cweilguny/cheeseroller/publish/images/Assembly_Step_03.jpg

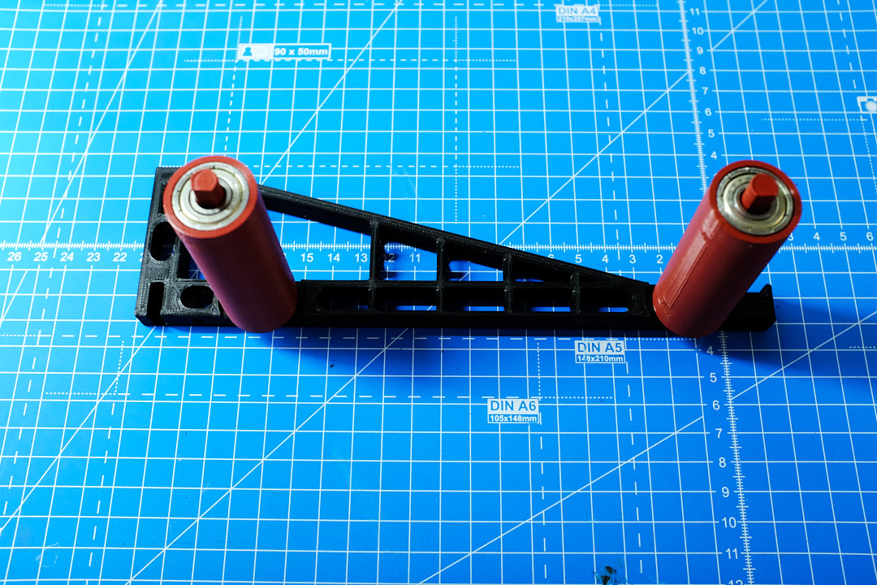
publish/images/Assembly_Step_03.jpg
