cweilguny/cheeseroller/publish/images/Overview_01.jpg

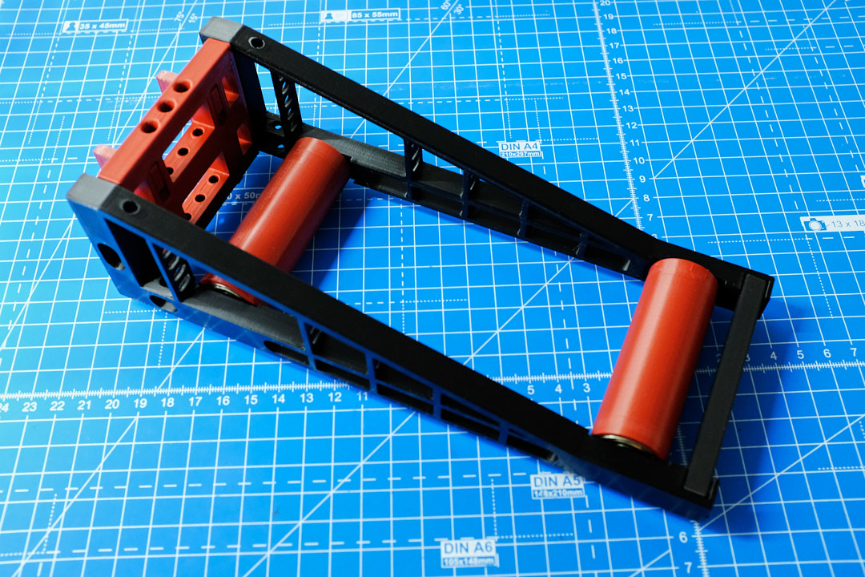
publish/images/Overview_01.jpg
