cweilguny/cheeseroller/README.md

# CheeseRoller

CheeseRoller is a 3D printable filament spool holder
for the Ikea Skadis pegboard that can be customized
to an arbitrary spool width.

See https://www.thingiverse.com/thing:4879591 for the
published version including all renderings.
