cweilguny/cheeseroller/publish/images/CheeseRollers.jpg

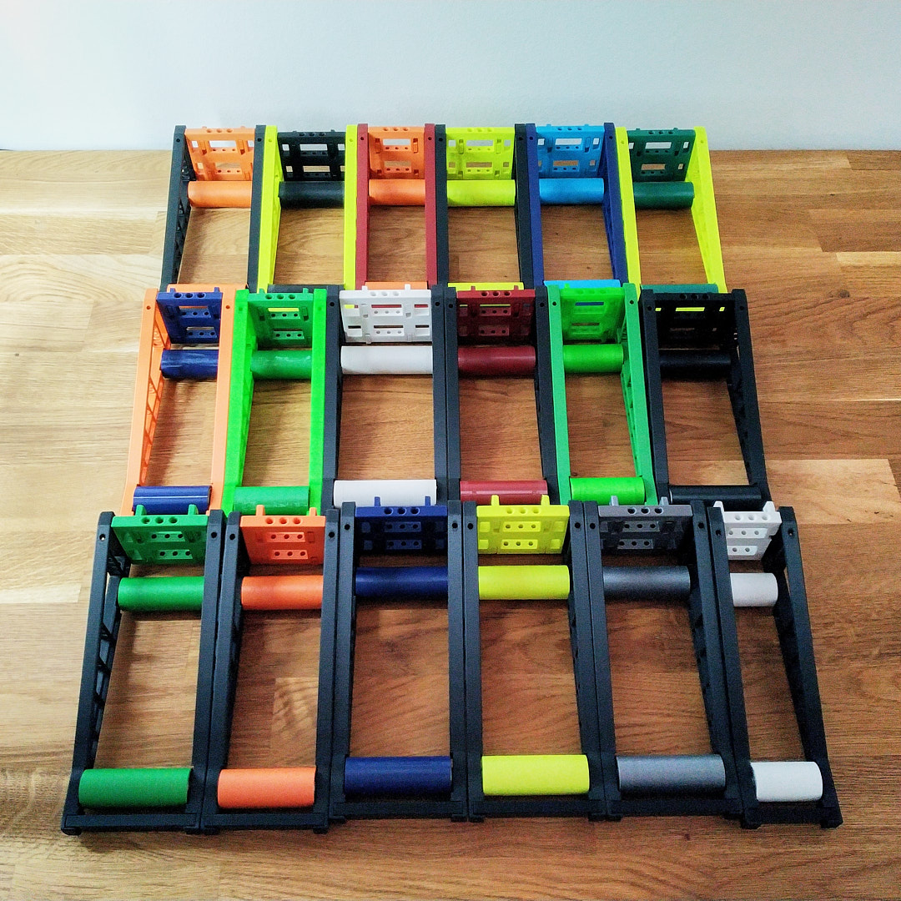
publish/images/CheeseRollers.jpg
