cweilguny/cheeseroller/publish/images/Overview_02.jpg

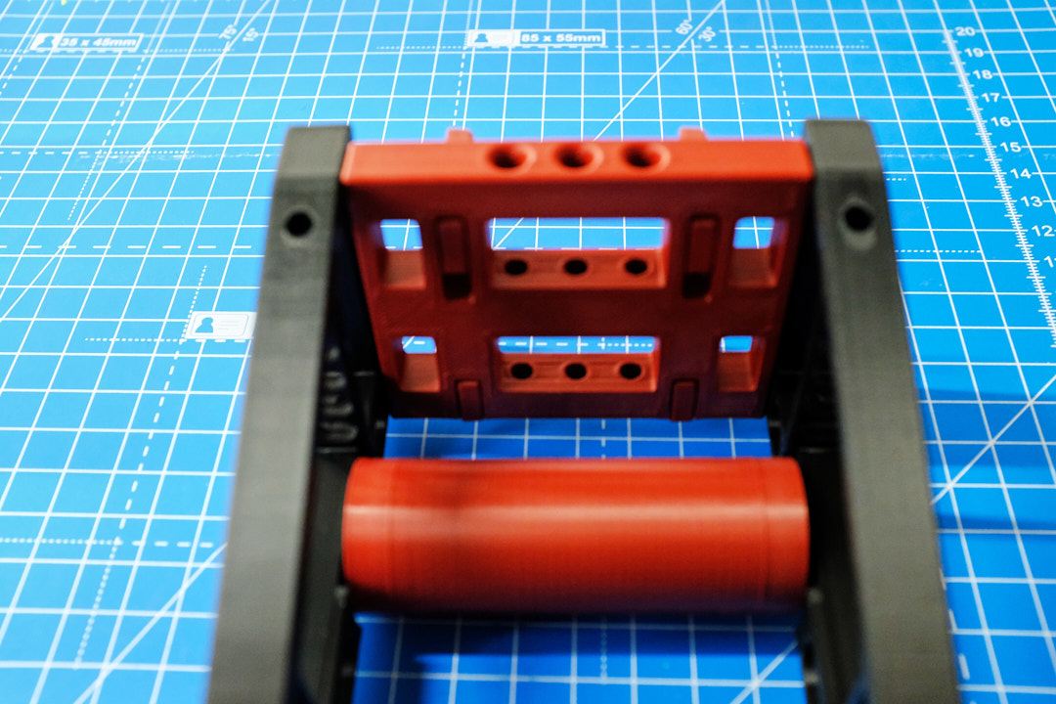
publish/images/Overview_02.jpg
