cweilguny/cheeseroller/publish/images/Overview_03.jpg

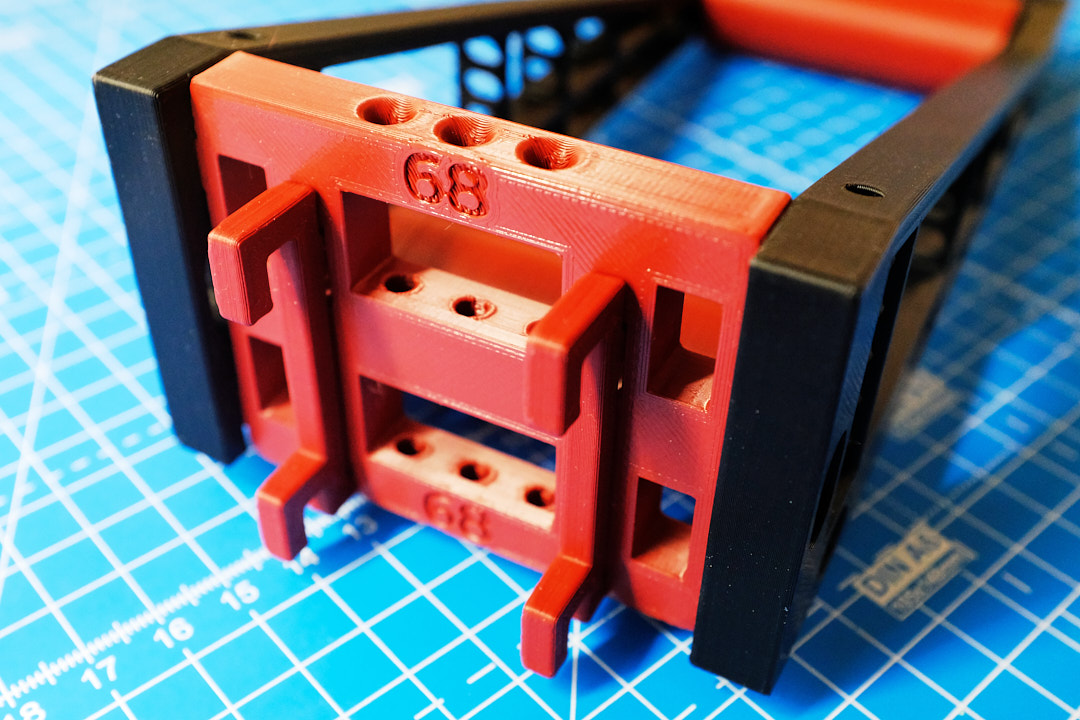
publish/images/Overview_03.jpg
