cweilguny/cheeseroller/publish/images/Spool_Wall_01.jpg

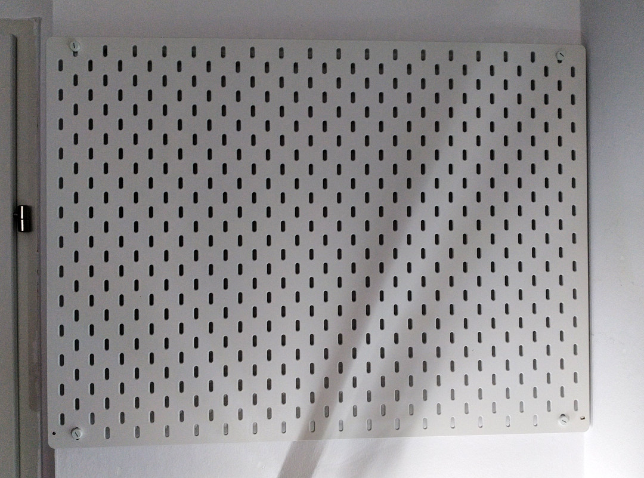
publish/images/Spool_Wall_01.jpg
