cweilguny/cheeseroller/publish/images/Spool_Wall_02.jpg

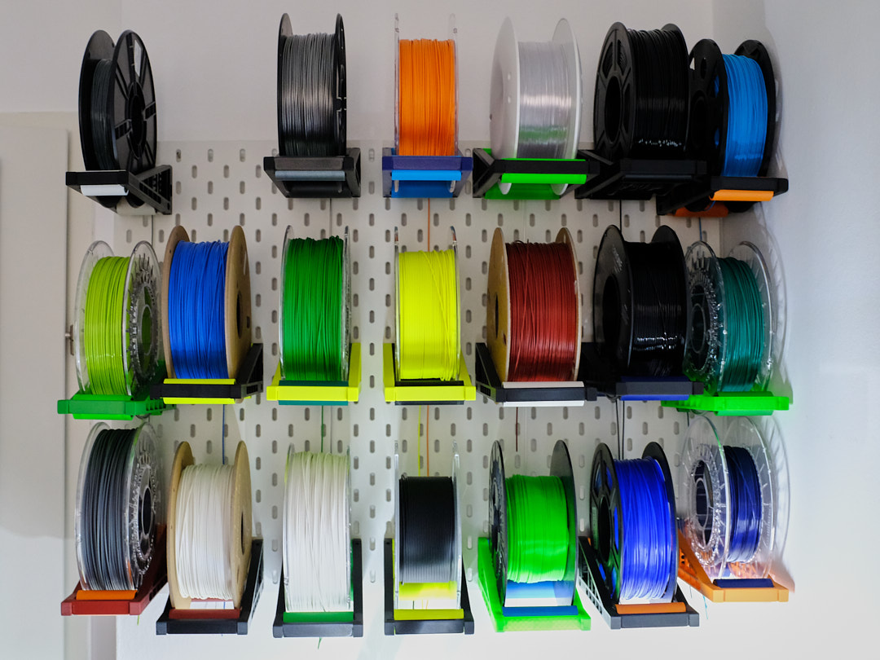
publish/images/Spool_Wall_02.jpg
