cweilguny/cheeseroller/publish/images/Spool_Wall_03.jpg

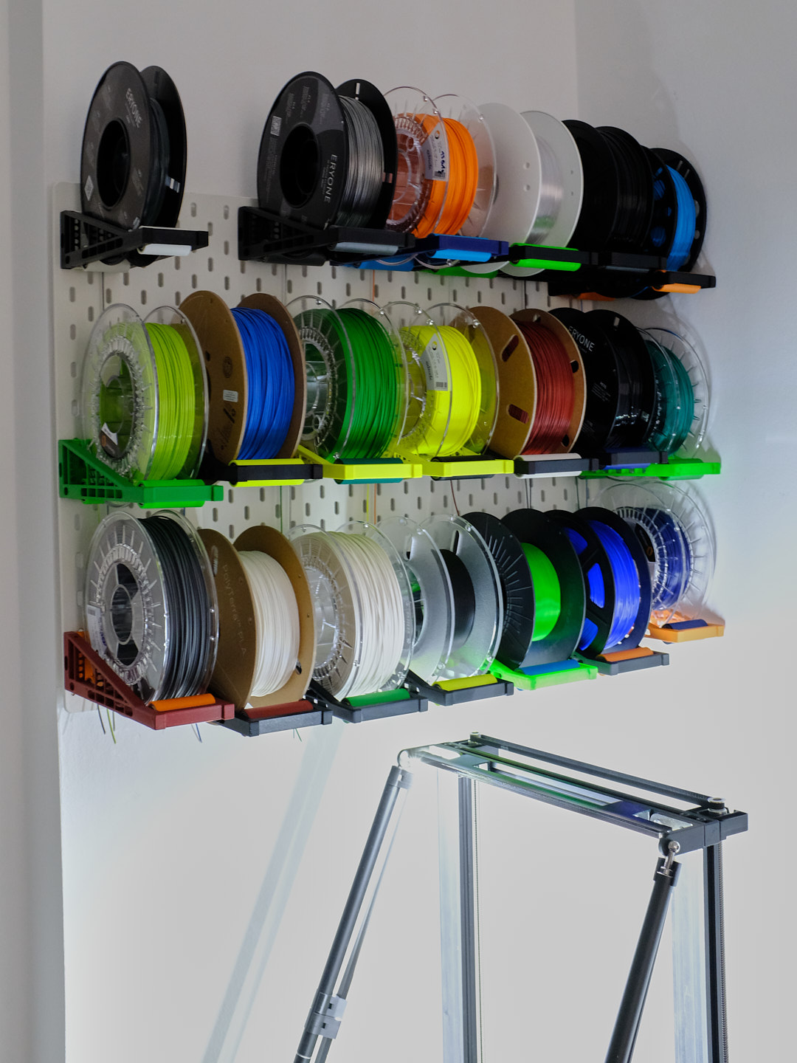
publish/images/Spool_Wall_03.jpg
