cweilguny/cheeseroller/publish/images/Spool_Wall_04.jpg

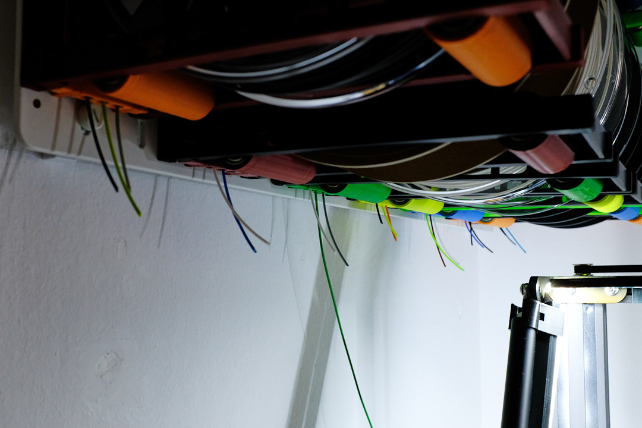
publish/images/Spool_Wall_04.jpg
