cweilguny/cheeseroller/publish/images/Spool_Wall_05.jpg

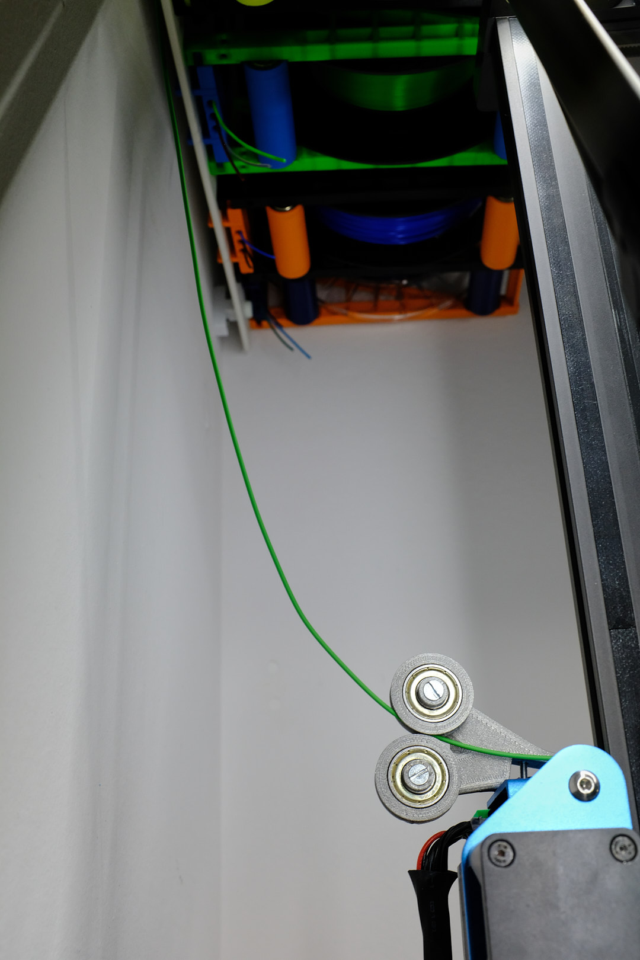
publish/images/Spool_Wall_05.jpg
