cweilguny/cheeseroller/scad/includes/CheeseRoller Variables Height Units.scad

HOOK_HEIGHT_TOTAL = HOOK_H * HEIGHT_UNITS + HOOK_DIFF_V * (HEIGHT_UNITS - 1);
