cweilguny/cheeseroller/publish/Assembly.md

Assembly and usage are easy. After the print assemble the parts like in the photographs:

**All parts including the 608ZZ bearings:**

----------------------------------------------------------------------------------------------------

**Put the bearings into the rolls on both sides. If they are a bit tight, press them in with a little more force, for example by pushing the roll on the bearing from the top.**

----------------------------------------------------------------------------------------------------

**The bearings seated in the rolls:**

----------------------------------------------------------------------------------------------------

**Put the pins through the bearing on one side, through the roll, and through the bearing on the other side:**

----------------------------------------------------------------------------------------------------

**The pins placed through the whole roll and both bearings:**

----------------------------------------------------------------------------------------------------

**Place the pins with the rolls on them into the slots in one arm:**

----------------------------------------------------------------------------------------------------

**Place the mount plate with the size label facing backwards into the slots of the arm:**

----------------------------------------------------------------------------------------------------

**Slide the mountplate towards the top of the arm until the top and the bottom of the mount plate are aligned with the top and bottom of the arm:**

----------------------------------------------------------------------------------------------------

**Place the second arm on the whole construction:**

----------------------------------------------------------------------------------------------------

**To fit the second arm, you need to skew the rolls and the arm a bit to fit the mount plate's hooks and both roll pins in the second arm:**

----------------------------------------------------------------------------------------------------

**Slide the mount plate towards the top of the second arm until the top and the bottom of the mount plate are aligned with the top and bottom of the arm:**

----------------------------------------------------------------------------------------------------

**Grab the connector:**

----------------------------------------------------------------------------------------------------

**Place it into the slots on the front of the arms, with the size label facing backwards:**

----------------------------------------------------------------------------------------------------

**Push the connector into the slots, until it's top is flush with the top of the arms:**

----------------------------------------------------------------------------------------------------

**Push the hooks through the slots on the mountplate:**

----------------------------------------------------------------------------------------------------

**Slide the hooks up so their bottom is flush with the mountplate's bottom:**

----------------------------------------------------------------------------------------------------

**You're done with the assembly, your new CheeseRoller should look like this:**
