cweilguny/cheeseroller/publish/images/Assembly_Step_00.jpg

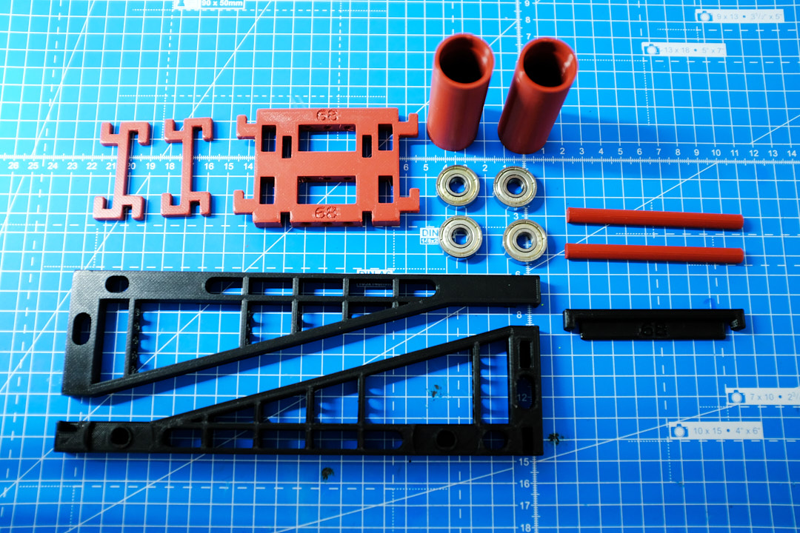
publish/images/Assembly_Step_00.jpg
