cweilguny/cheeseroller/publish/images/Assembly_Step_01a.jpg

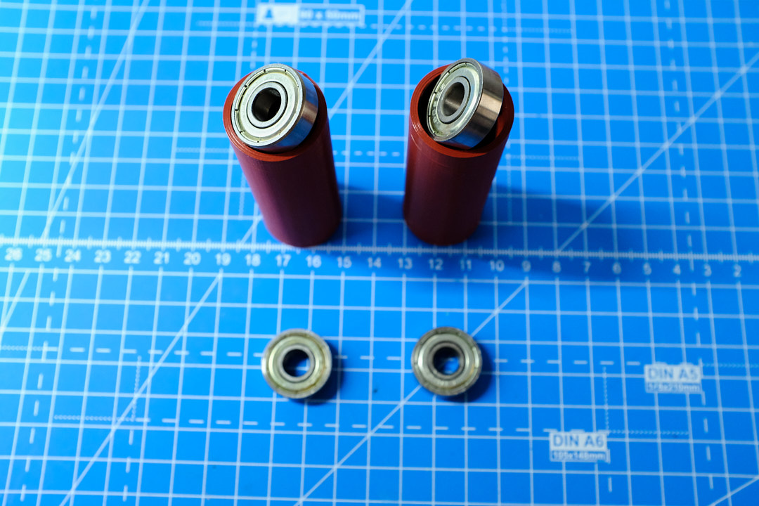
publish/images/Assembly_Step_01a.jpg
