cweilguny/cheeseroller/publish/images/Assembly_Step_01b.jpg

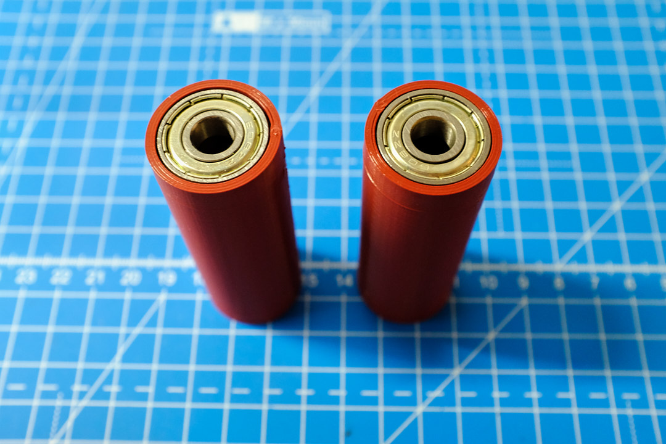
publish/images/Assembly_Step_01b.jpg
