cweilguny/cheeseroller/publish/images/Assembly_Step_02a.jpg

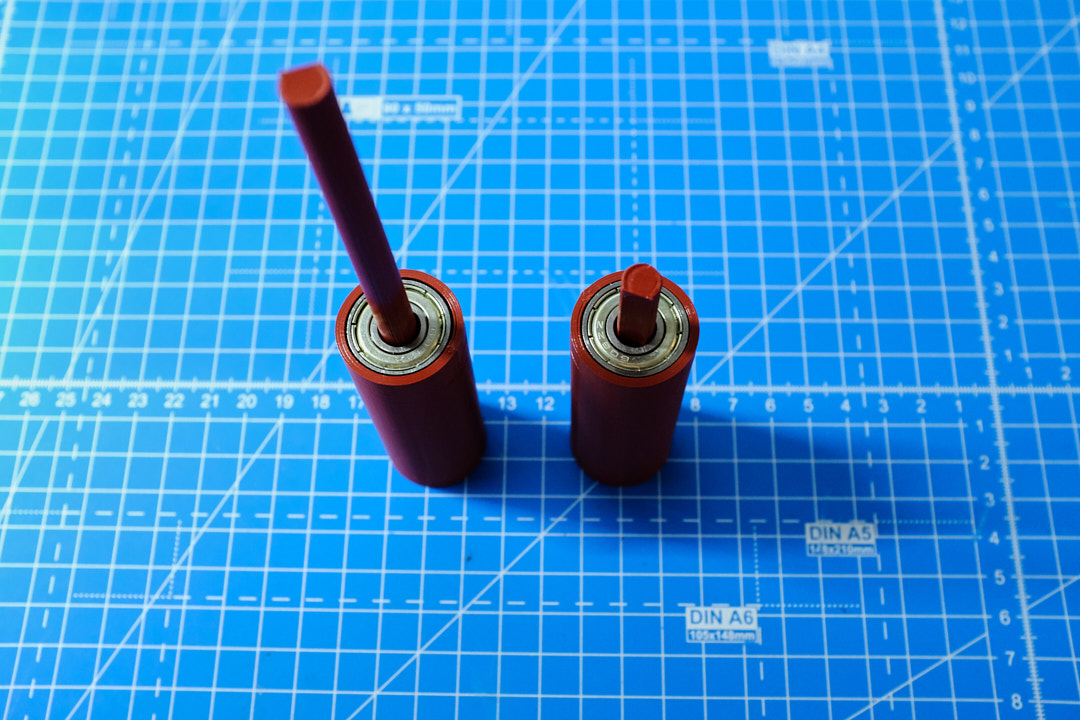
publish/images/Assembly_Step_02a.jpg
