cweilguny/cheeseroller/publish/images/Assembly_Step_02b.jpg

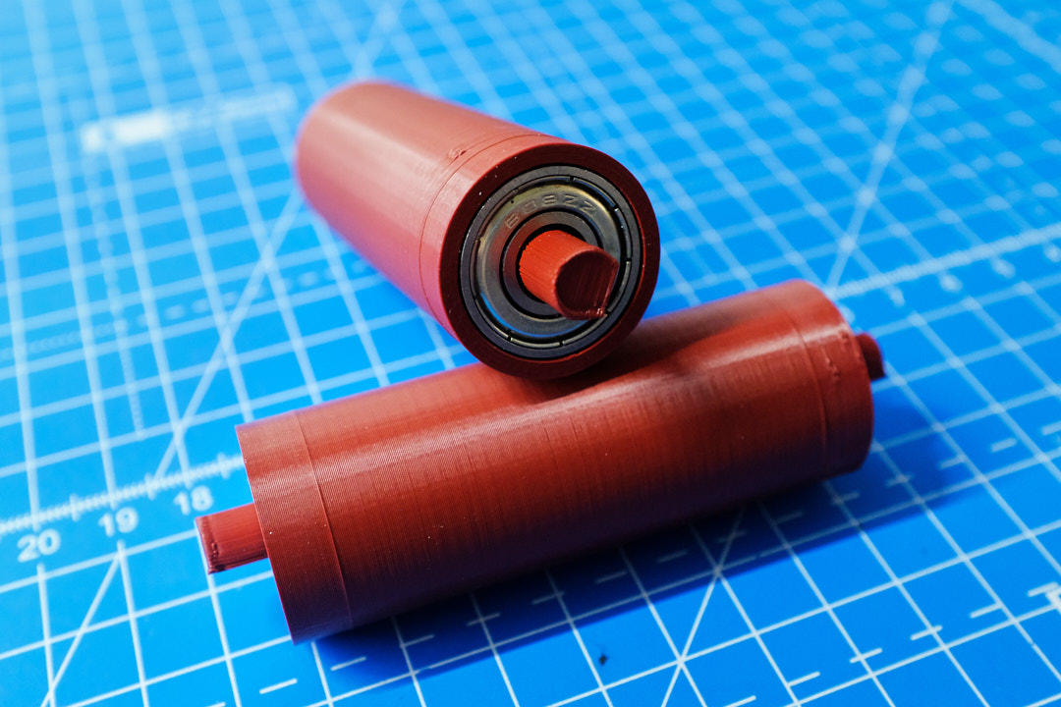
publish/images/Assembly_Step_02b.jpg
