cweilguny/cheeseroller/publish/images/Assembly_Step_04a.jpg

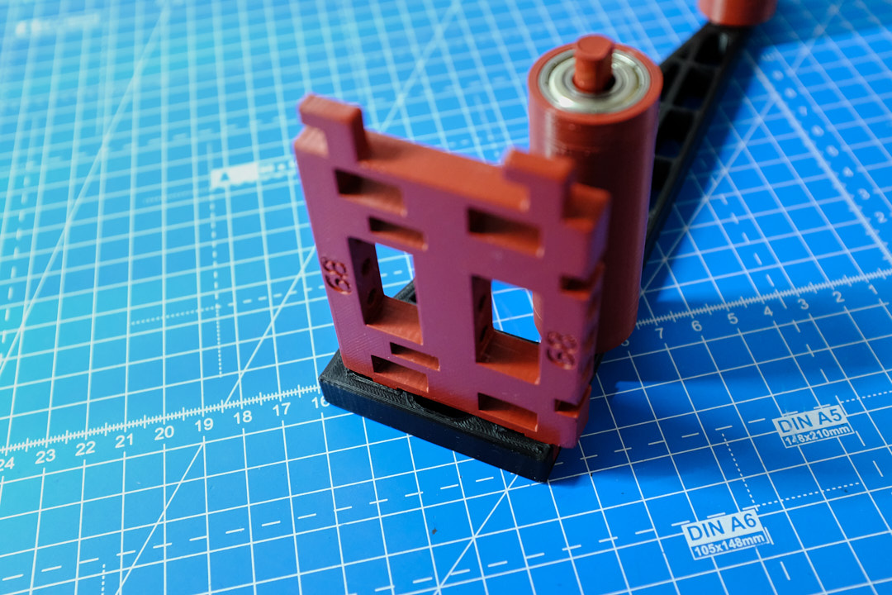
publish/images/Assembly_Step_04a.jpg
