cweilguny/cheeseroller/publish/images/Assembly_Step_04b.jpg

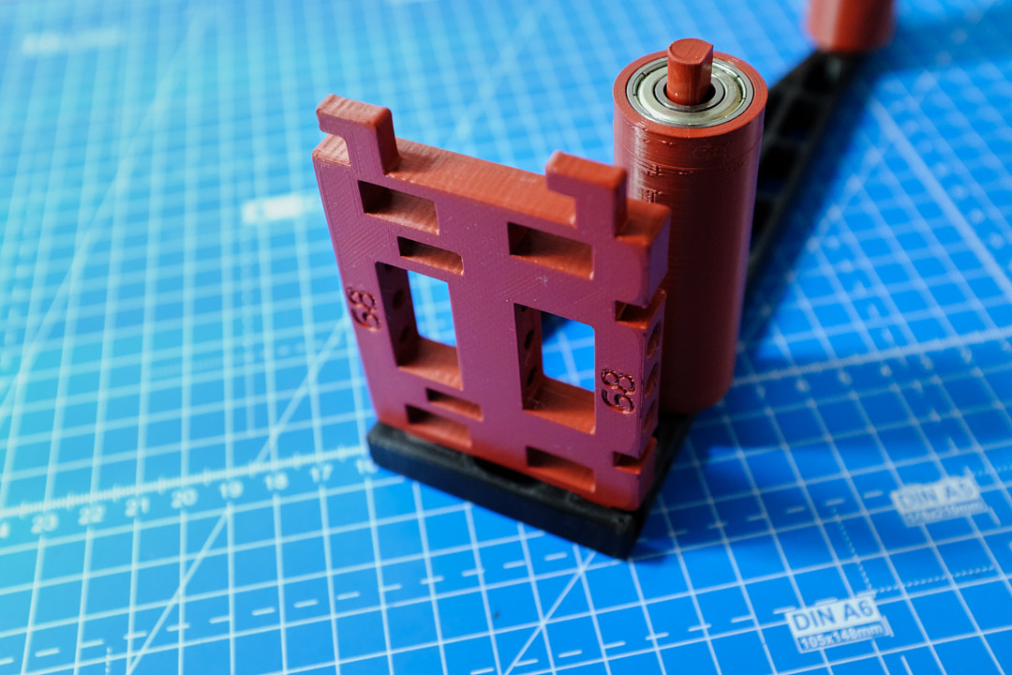
publish/images/Assembly_Step_04b.jpg
