cweilguny/cheeseroller/publish/images/Assembly_Step_05a.jpg

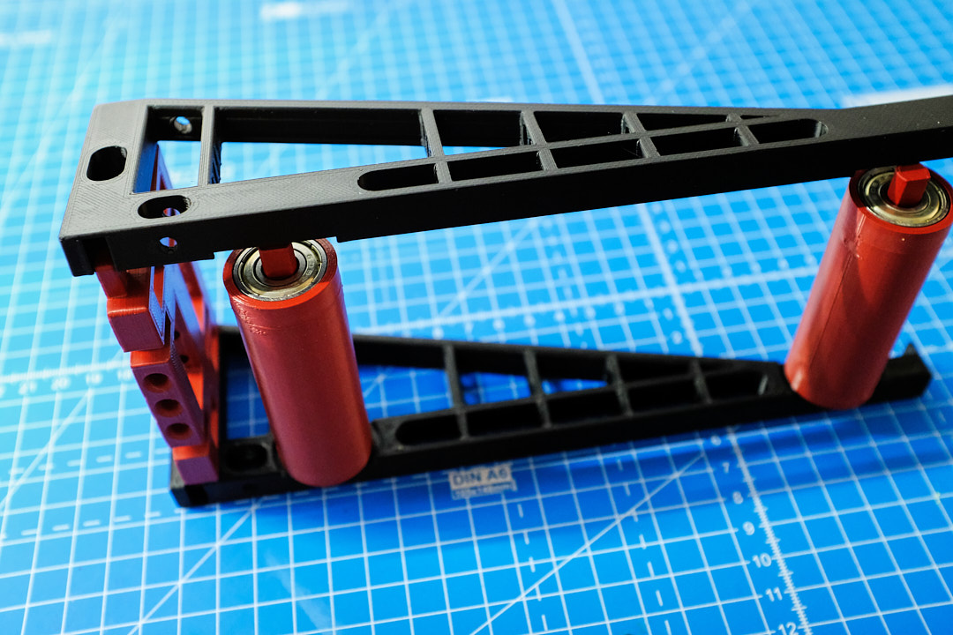
publish/images/Assembly_Step_05a.jpg
