cweilguny/cheeseroller/publish/images/Assembly_Step_05b.jpg

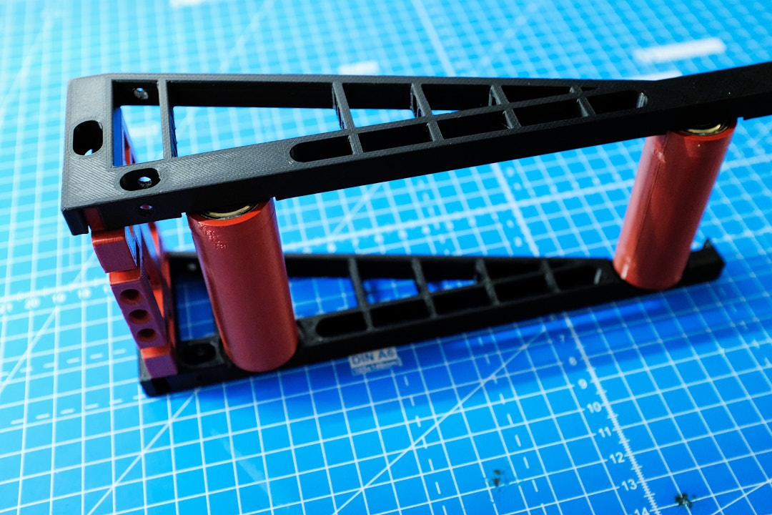
publish/images/Assembly_Step_05b.jpg
