cweilguny/cheeseroller/publish/images/Assembly_Step_05c.jpg

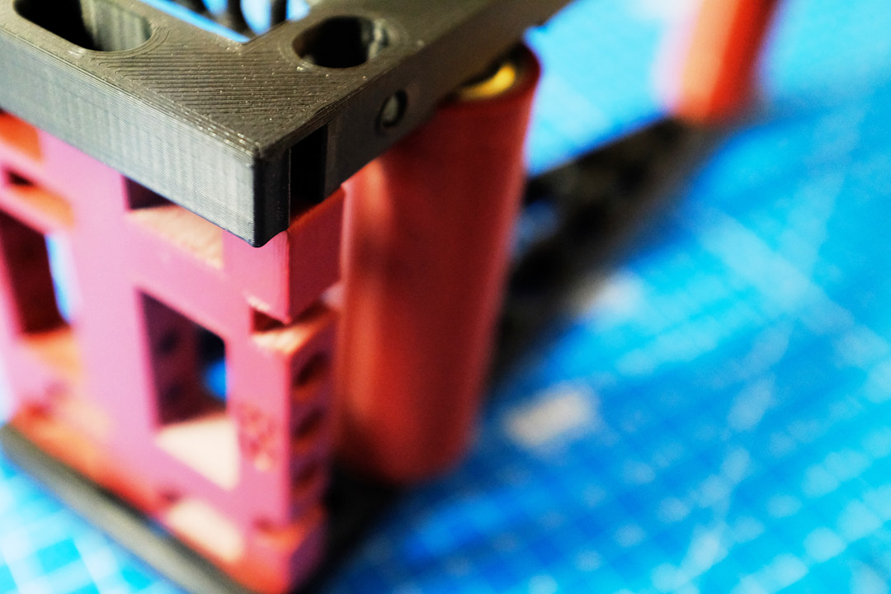
publish/images/Assembly_Step_05c.jpg
