cweilguny/cheeseroller/publish/images/Assembly_Step_06a.jpg

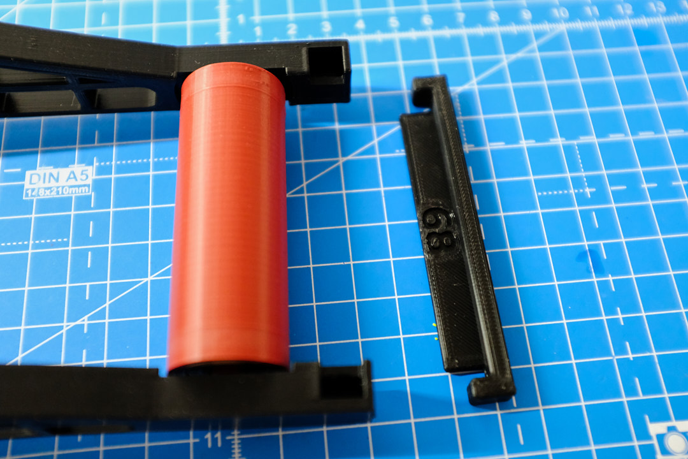
publish/images/Assembly_Step_06a.jpg
