cweilguny/cheeseroller/publish/images/Assembly_Step_06b.jpg

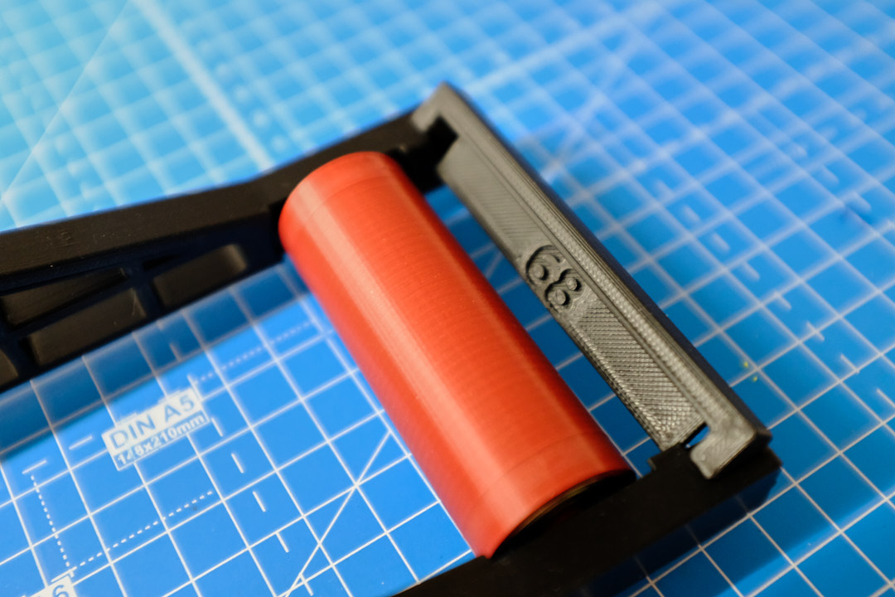
publish/images/Assembly_Step_06b.jpg
