cweilguny/cheeseroller/publish/images/Assembly_Step_06c.jpg

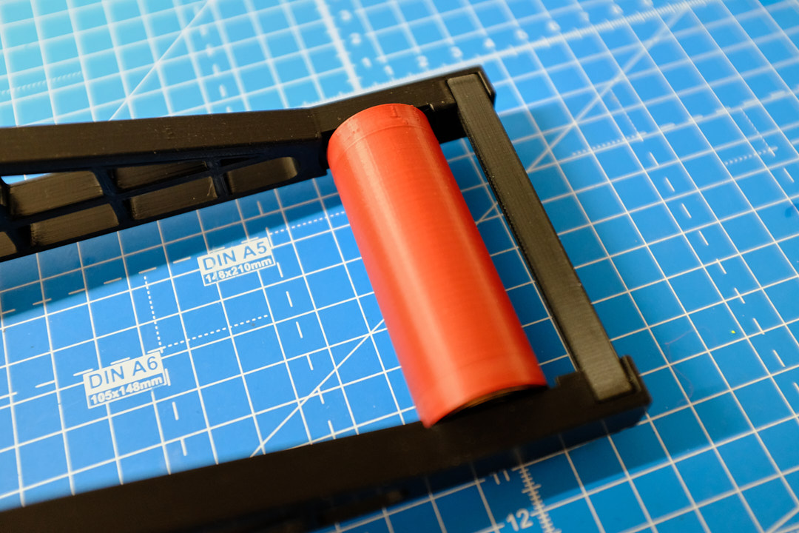
publish/images/Assembly_Step_06c.jpg
