cweilguny/cheeseroller/publish/images/Assembly_Step_07a.jpg

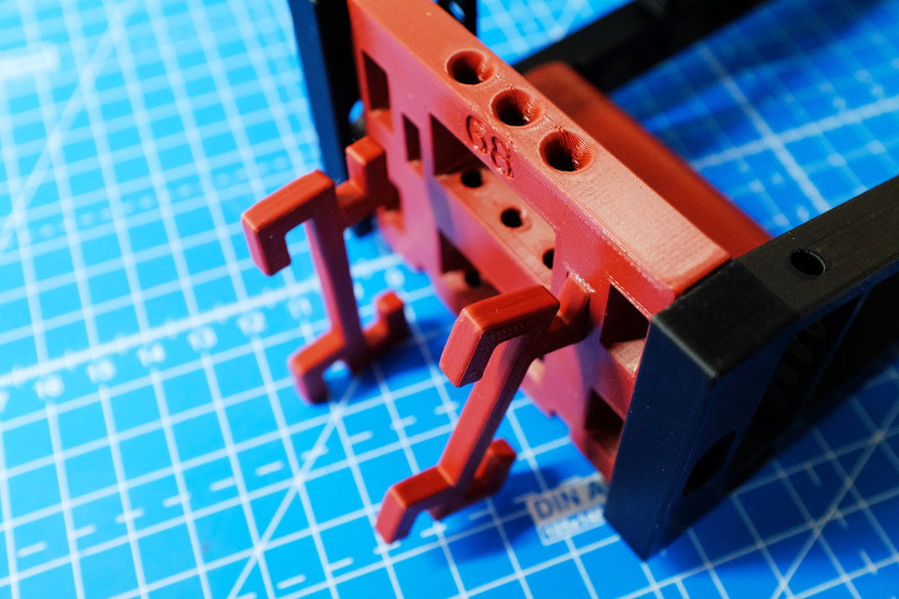
publish/images/Assembly_Step_07a.jpg
