cweilguny/cheeseroller/publish/images/Assembly_Step_07b.jpg

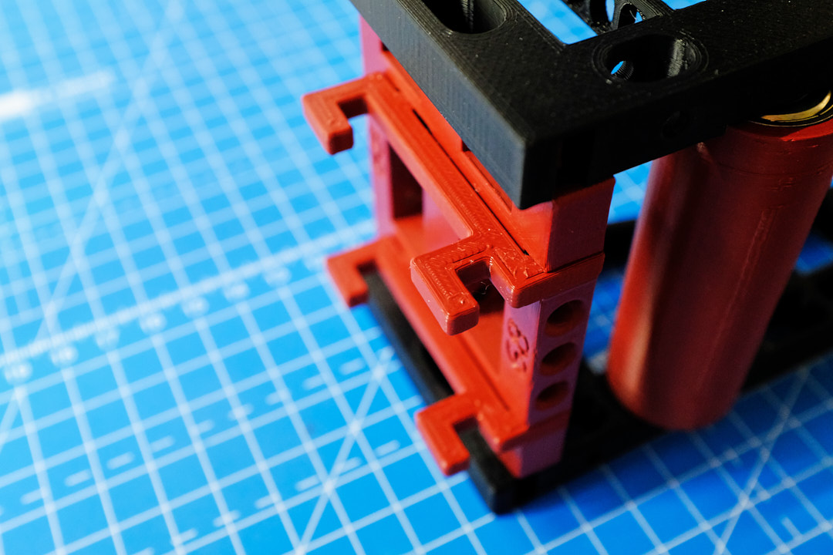
publish/images/Assembly_Step_07b.jpg
