cweilguny/cheeseroller/(commit log)

2021-05-21 Add first publish-ready version of the CheeseRoller
    [CheeseRoller Arm.scad, CheeseRoller Connector.scad, CheeseRoller Hook.scad, CheeseRoller Mount.scad, CheeseRoller Pin.scad, CheeseRoller Roll.scad, CheeseRoller Utilities.scad, CheeseRoller Variables Height Units.scad]
2021-05-21 Add round edges also on the inside of the PTFE tube holes
    [CheeseRoller Mount.scad]
2021-05-22 Make mount more robust
    [CheeseRoller Mount.scad]
2021-05-22 Switch to different font name
    [CheeseRoller Connector.scad, CheeseRoller Mount.scad, CheeseRoller Pin.scad, CheeseRoller Roll.scad]
